dumbledore90/zmk-config/docs/左手_配置座標表.md

---
project: oyayubi_01
type: PCB配置座標表（左手）
updated: 2026-09-21 (v2)
source: oya01_Assemble_L.kicad_pcb (2a0195ec) 実測 + pin_assignment.md v1.0
---

# 左手 配置座標表（27キー）

## v2での変更

**COL0 / COL4 のスタガー量を実機に合わせて更新。** 初版は両方0mmとしていたが、
実基板では COL0 = 1.23mm / COL4 = 2.18mm 上にオフセットしている（意図的な調整）。
以下の表はすべて **PCB実測値**。

---

## 使い方

1. グリッド: **ユーザー定義 X = `18` / Y = `17/4` (=4.25)**
   ※ COL0 / COL4 は半端なオフセットなので、`E` キーで数値直接入力する
2. フットプリントを選択 → **`E` キー** → プロパティの位置 X / Y に数値入力
3. **原点(0,0) = COL2 × ROW0 (SW11 / `#`) の中心** = 最上段キー

---

## 座標表

| SW | 行 | 列 | キー | X (mm) | Y (mm) | ダイオード |
|---|---|---|---|---:|---:|---|
| **SW1** | Row0 | Col0 | ! (?) | 0 | **11.52** | D1 |
| **SW6** | Row0 | Col1 | @ (/) | 18 | 4.25 | D6 |
| **SW11** | Row0 | Col2 | # (F2) | 36 | 0 | D11 |
| **SW16** | Row0 | Col3 | $ (F3) | 54 | 8.5 | D16 |
| **SW21** | Row0 | Col4 | % (F4) | 72 | **10.57** | D21 |
| **SW2** | Row1 | Col0 | Q | 0 | **28.52** | D2 |
| **SW7** | Row1 | Col1 | W | 18 | 21.25 | D7 |
| **SW12** | Row1 | Col2 | E (7) | 36 | 17 | D12 |
| **SW17** | Row1 | Col3 | R (8) | 54 | 25.5 | D17 |
| **SW22** | Row1 | Col4 | T (9) | 72 | **27.57** | D22 |
| **SW3** | Row2 | Col0 | A | 0 | **45.52** | D3 |
| **SW8** | Row2 | Col1 | S | 18 | 38.25 | D8 |
| **SW13** | Row2 | Col2 | D (4) | 36 | 34 | D13 |
| **SW18** | Row2 | Col3 | F (5) | 54 | 42.5 | D18 |
| **SW23** | Row2 | Col4 | G (6) | 72 | **44.57** | D23 |
| **SW4** | Row3 | Col0 | Z (↑) | 0 | **62.52** | D4 |
| **SW9** | Row3 | Col1 | X (0) | 18 | 55.25 | D9 |
| **SW14** | Row3 | Col2 | C (1) | 36 | 51 | D14 |
| **SW19** | Row3 | Col3 | V (2) | 54 | 59.5 | D19 |
| **SW24** | Row3 | Col4 | B (3) | 72 | **61.57** | D24 |
| **SW5** | Row4 | Col0 | shift | 0 | 80.75 | D5 |
| **SW10** | Row4 | Col1 | ctrl (←) | 18 | 80.75 | D10 |
| **SW15** | Row4 | Col2 | option (↓) | 36 | 80.75 | D15 |
| **SW20** | Row4 | Col3 | win/cmd (→) | 54 | 80.75 | D20 |
| **SW25** | Row4 | Col4 | alt | 72 | 80.75 | D25 |
| **SW26** | Row4 | Col5 | space | 90 | 80.75 | D26 |
| **SW27** | Row4 | Col6 | 空きキー | 108 | 80.75 | **D27** |

- ダイオード番号は **D番号 = SW番号**（SW1〜SW26）。**例外は SW27 → D27** のみ
- SW28 = スライドスイッチ、SW29 = リセットスイッチ（マトリクス外）
- ダイオードは全数 **スイッチ中心から (0, −5.0) / rot=0 / F.Cu**（27個すべて実測で一致）

---

## 列X座標とスタガー

| 列 | Col0 | Col1 | Col2 | Col3 | Col4 | Col5 | Col6 |
|---|---:|---:|---:|---:|---:|---:|---:|
| X (mm) | 0 | 18 | 36 | 54 | 72 | 90 | 108 |
| 指 | 小指 | 薬指 | 中指 | 人差 | 人差(内) | 親指 | 親指(内) |
| **上オフセット (mm)** | **1.23** | 8.5 | 12.75 | 4.25 | **2.18** | 0 | 0 |
| 右手の対応列 | — | Col4 | Col3 | Col2 | — | Col6 | Col7 |

- **中指列 (Col2) が最も高い**
- Col1 / Col2 / Col3 は右手と完全な鏡像（8.5 / 12.75 / 4.25）
- **Col0 と Col4 は左手独自**。小指列と人差し指内側列をわずかに持ち上げている
- 最下段 (Row4) は**スタガーなしのフラット行** — 全列 Y=80.75
- 行番号の向き: **Row0 = 最上段 / Row4 = 最下段**

### Y値の計算式

```
Row0〜Row3 :  Y = (12.75 + 17 × Row) − 列オフセット
Row4       :  Y = 80.75 （全列共通、オフセット無視）
```

---

## トラックパッド (φ30mm)

| 項目 | 値 |
|---|---|
| 中心 | **(102.50, 54.00)** |
| マーカー円 | φ30 / User.1 レイヤー |
| **銅ベタ キープアウト** | **φ34 / 中心同じ / F.Cu + B.Cu** |
| キープアウト設定 | 配線=許可 / ビア=禁止 / パッド=禁止 / **ベタ塗り=禁止** |
| 円内を通る配線 | **ゼロ**（実測確認済み） |
| マージン | パッド外周から 2.0mm 均等 |

静電容量式センサーの直下にソリッドGNDがあると寄生容量が増えて感度が落ちるため、
両面ともベタを抜いてある。

---

## 周辺部品の実装座標

| 部品 | X | Y | 角度 | レイヤー |
|---|---:|---:|---|---|
| U1 (XIAO nRF52840 Plus) | 94.655 | 12.080 | 90 | F.Cu |
| SW29 (リセット) | 100.500 | 26.140 | 180 | F.Cu |
| SW28 (スライド) | 109.390 | 2.020 | 0 | F.Cu |
| J1 (電池コネクタ) | 110.150 | 31.100 | −90 | **B.Cu** |
| Track_pad1 (FFC変換) | 89.120 | 35.705 | 0 | F.Cu |

右手と違い COL0〜COL4 が5行フルに埋まっているため、周辺部品は**内側（高X側）**に配置。
トラックパッド円の外に出すため、FFCコネクタは円の左上に置いている。

### ネジ穴 (M2 / φ2.2)

| | H1 | H2 | H3 | H4 | H5 | H6 | H7 |
|---|---:|---:|---:|---:|---:|---:|---:|
| X | 117.00 | 23.51 | −10.51 | −10.25 | 41.13 | 117.02 | 117.40 |
| Y | 3.12 | −7.43 | 2.49 | 90.74 | 67.74 | 68.39 | 90.80 |

---

## 全体寸法

| | 左手 | 右手 |
|---|---|---|
| 基板外形 | **133.40 × 103.74 mm** | 150.84 × 103.03 mm |
| 外形範囲 | X[−13.39, 120.01] / Y[−10.21, 93.53] | — |
| キー数 | 27 | 37 + エンコーダ |
| 穴総数 | 387 | 530 |

---

## 配線ルール（右手と共通・実測で一致確認済み）

| 種類 | レイヤー | 線幅 |
|---|---|---|
| ROW (カソード連結・横) | **F.Cu** | 0.3 mm |
| COL (スイッチpad1連結・縦) | **B.Cu** | 0.3 mm |
| スイッチpad2 ⇔ ダイオードアノード | **F.Cu** | 0.3 mm |
| Bat+ / BAT_SW / Reset | F.Cu | 0.4 mm |
| GND | 両面ベタ（トラックパッド下は除外） | — |
| ビア | — | φ0.8 / drill 0.4 |

実測: 0.3mm × 251本 / 0.4mm × 27本、ビア19本（GND 15 + 層移動 7... のうちGND15）。
