dumbledore90/zmk-config/docs/右手_配置座標表.md

---
project: oyayubi_01
type: PCB配置座標表（右手）
updated: 2026-09-27
source: oya01_Assemble_R_v2.kicad_pcb のネット接続とフットプリント座標を直読み
---

# 右手 配置座標表（37キー + エンコーダ）

## 使い方

1. **原点(0,0) = ROW3 × COL0 (SW1)** ではなく、**Y基準は Col1 の Row0 = 12.75**
2. 行の向き: **Row0 = 最上段 / Row4 = 最下段**
3. 列 X は 18mm 等間隔（Col0=0 〜 Col7=126）

## 座標表

| Row | Col | SW | X (mm) | Y (mm) | ダイオード |
|---|---|---|---:|---:|---|
| Row0 | Col1 | **SW3** | 18 | 12.75 | D3 |
| Row0 | Col2 | **SW8** | 36 | 8.5 | D8 |
| Row0 | Col3 | **SW13** | 54 | 0 | D13 |
| Row0 | Col4 | **SW18** | 72 | 4.25 | D18 |
| Row0 | Col5 | **SW23** | 90 | 12.75 | D23 |
| Row0 | Col6 | **SW28** | 108 | 12.75 | D28 |
| Row0 | Col7 | **SW33** | 126 | 12.75 | D33 |
| Row1 | Col1 | **SW4** | 18 | 29.75 | D4 |
| Row1 | Col2 | **SW9** | 36 | 25.5 | D9 |
| Row1 | Col3 | **SW14** | 54 | 17 | D14 |
| Row1 | Col4 | **SW19** | 72 | 21.25 | D19 |
| Row1 | Col5 | **SW24** | 90 | 29.75 | D24 |
| Row1 | Col6 | **SW29** | 108 | 29.75 | D29 |
| Row1 | Col7 | **SW34** | 126 | 29.75 | D34 |
| Row2 | Col0 | **SW39** | -1 | 46 | D38 ← **エンコーダのプッシュ** |
| Row2 | Col1 | **SW5** | 18 | 46.75 | D5 |
| Row2 | Col2 | **SW10** | 36 | 42.5 | D10 |
| Row2 | Col3 | **SW15** | 54 | 34 | D15 |
| Row2 | Col4 | **SW20** | 72 | 38.25 | D20 |
| Row2 | Col5 | **SW25** | 90 | 46.75 | D25 |
| Row2 | Col6 | **SW30** | 108 | 46.75 | D30 |
| Row2 | Col7 | **SW35** | 126 | 46.75 | D35 |
| Row3 | Col0 | **SW1** | 0 | 63.75 | D1 |
| Row3 | Col1 | **SW6** | 18 | 63.75 | D6 |
| Row3 | Col2 | **SW11** | 36 | 59.5 | D11 |
| Row3 | Col3 | **SW16** | 54 | 51 | D16 |
| Row3 | Col4 | **SW21** | 72 | 55.25 | D21 |
| Row3 | Col5 | **SW26** | 90 | 63.75 | D26 |
| Row3 | Col6 | **SW31** | 108 | 63.75 | D31 |
| Row3 | Col7 | **SW36** | 126 | 63.75 | D36 |
| Row4 | Col0 | **SW2** | 0 | 80.75 | D2 |
| Row4 | Col1 | **SW7** | 18 | 80.75 | D7 |
| Row4 | Col2 | **SW12** | 36 | 80.75 | D12 |
| Row4 | Col3 | **SW17** | 54 | 80.75 | D17 |
| Row4 | Col4 | **SW22** | 72 | 80.75 | D22 |
| Row4 | Col5 | **SW27** | 90 | 80.75 | D27 |
| Row4 | Col6 | **SW32** | 108 | 80.75 | D32 |
| Row4 | Col7 | **SW37** | 126 | 80.75 | D37 |

- **Row2 × Col0 = SW39（ロータリーエンコーダのプッシュスイッチ）**。通常のキースイッチではない
- SW39 の座標 (−1.00, 46.00) はエンコーダ本体の中心。キー格子から外れている
- **Col0 は Row2 / Row3 / Row4 の3セルのみ**。Row0・Row1 に Col0 は存在しない
- ダイオード番号は D番号 = SW番号。**例外は SW39 → D38**
- ダイオードは全数 **裏面 (B.Cu) / rot=0 / カソード(pad1) はスイッチ中心から X−1.65**

## 列Xとスタガー

| 列 | Col0 | Col1 | Col2 | Col3 | Col4 | Col5 | Col6 | Col7 |
|---|---:|---:|---:|---:|---:|---:|---:|---:|
| X (mm) | 0 | 18 | 36 | 54 | 72 | 90 | 108 | 126 |
| **上オフセット (mm)** | **0** | **0** | **4.25** | **12.75** | **8.50** | **0** | **0** | **0** |
| 左手で同じ値を持つ列 | — | — | Col3 (人差) | Col2 (中指) | Col1 (薬指) | — | — | — |
| 指（**スタガー値からの推定**） | 親指(内) | 人差(内) | 人差 | 中指 | 薬指 | 小指 | 小指(外) | 小指(外2) |

> ⚠️ **指の行は推定。** 基板ファイルに指の情報は入っていないので、
> 「左手と同じスタガー値を持つ列は同じ指」という仮定から逆算した。
> 実際の運指と違っていたら教えてほしい。座標そのものは実測値で確実。

### Y値の計算式

```
Row0〜Row3 :  Y = (12.75 + 17 × Row) − 列オフセット
Row4       :  Y = 80.75 （全列共通、オフセット無視）
```

左手とまったく同じ式が使える。

## 左右のスタガー比較

指ごとに並べ直すと、**4本指のスタガーは左右で完全に一致している**。

| 指 | 左手 | 右手 | 一致 |
|---|---|---|---|
| 人差 | Col3 = **4.25** | Col2 = **4.25** | ✅ |
| 中指 | Col2 = **12.75** | Col3 = **12.75** | ✅ |
| 薬指 | Col1 = **8.50** | Col4 = **8.50** | ✅ |
| 小指 | Col0 = 1.23 | Col5 = 0 | 差 1.23mm |

**左右で違うのは2点だけ：**

1. **小指列が左は 1.23mm 上、右は 0**（わずかな差）
2. **列数が違う。** 左は7列、右は8列
   - 左には「人差し指の内側」列 (Col4, offset 2.18) がある
   - 右には**小指側に追加の2列** (Col6, Col7) がある。どちらもオフセット 0

つまり**基本のスタガー設計は左右対称で、周辺列の数だけが非対称**。
右手が37キー・左手が27キーという構成はここから来ている。

## ZMK 統合レイアウトの位置順（検証済み）

左7列 + 右8列 = **columns 15** / 右の **col-offset = 7**。
行ごとに「左を左から右へ → 右を左から右へ」の順に並べると次のようになる。

| 行 | 左（Col） | 右（Col） | その行のキー数 |
|---|---|---|---:|
| Row0 | 0,1,2,3,4 | 1,2,3,4,5,6,7 | 12 |
| Row1 | 0,1,2,3,4 | 1,2,3,4,5,6,7 | 12 |
| Row2 | 0,1,2,3,4 | **0**,1,2,3,4,5,6,7 | 13 |
| Row3 | 0,1,2,3,4 | **0**,1,2,3,4,5,6,7 | 13 |
| Row4 | 0,1,2,3,4,5,6 | 0,1,2,3,4,5,6,7 | 15 |
| | | **合計** | **65** |

統合座標での列番号は、左が 0〜6、右が **7 + 右Col** （右Col0 → 7、右Col7 → 14）。

## 検証記録（2026-09-27）

- 基板ファイルのネット接続から Row/Col を直接抽出。**38セル・重複ゼロ**
- 行別セル数 Row0:7 / Row1:7 / Row2:8 / Row3:8 / Row4:8
- 回路図のシンボル定義（pin15=D11, pin21=D17, pin22=D18, pin23=D19）とも一致
- 左手も同時に再検証。**27セル・重複ゼロ**、既存の左手座標表と完全一致
