dumbledore90/zmk-config/docs/oya01_Assemble_R_v2.kicad_pcb

## KiCad design docs/oya01_Assemble_R_v2.kicad_pcb (2026-09-27)

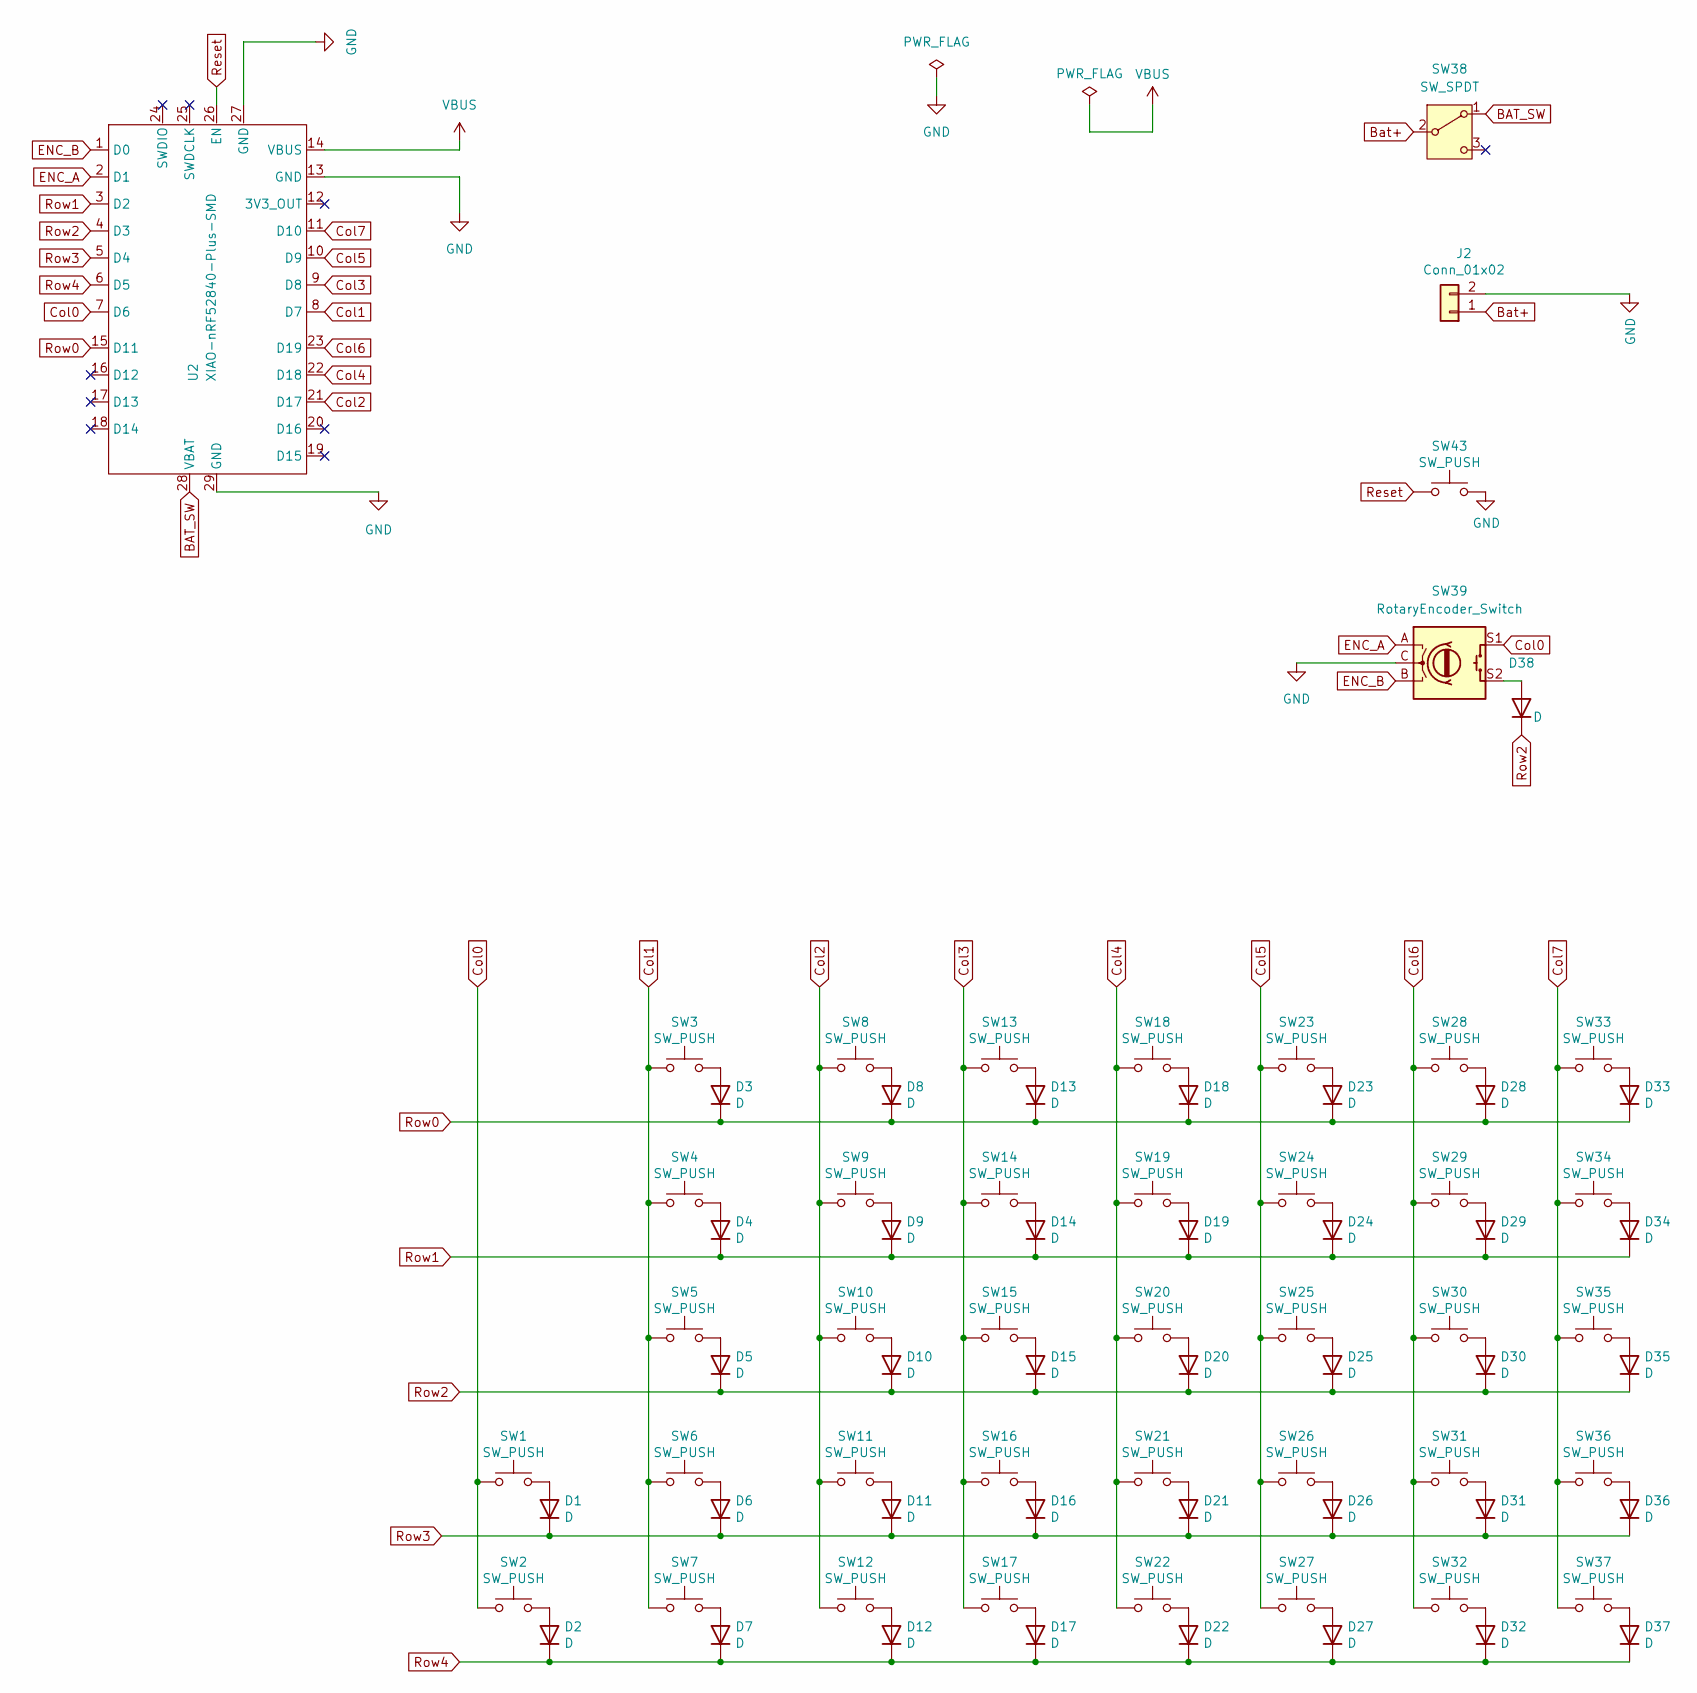
[picture p1: schematic oya01_Assemble_R_v2.kicad_sch]

Parts:
D1, D2, D3, D4, D5, D6, D7, D8, D9, D10, D11, D12, D13, D14, D15, D16, D17, D18, D19, D20, D21, D22, D23, D24, D25, D26, D27, D28, D29, D30, D31, D32, D33, D34, D35, D36, D37, D38: D; D_SOD-123
J2: Conn_01x02; JST_PH_S2B-PH-K_1x02_P2.00mm_Horizontal
SW1, SW2, SW3, SW4, SW5, SW6, SW7, SW8, SW9, SW10, SW11, SW12, SW13, SW14, SW15, SW16, SW17, SW18, SW19, SW20, SW21, SW22, SW23, SW24, SW25, SW26, SW27, SW28, SW29, SW30, SW31, SW32, SW33, SW34, SW35, SW36, SW37: SW_PUSH; Kailh_Choc_V1_Hotswap_thin_via
SW38: SW_SPDT; TGSW_MSK-12D19
SW39: RotaryEncoder_Switch; RotaryEncoder_EC12E
SW43: SW_PUSH; ResetSW
U2: XIAO-nRF52840-Plus-SMD

Connections:
BAT_SW: SW38.1 (A), U2.28 (VBAT)
Bat+: J2.1, SW38.2 (B)
Col0: SW1.1, SW2.1, SW39.S1, U2.7 (D6)
Col1: SW3.1, SW4.1, SW5.1, SW6.1, SW7.1, U2.8 (D7)
Col2: SW8.1, SW9.1, SW10.1, SW11.1, SW12.1, U2.21 (D17)
Col3: SW13.1, SW14.1, SW15.1, SW16.1, SW17.1, U2.9 (D8)
Col4: SW18.1, SW19.1, SW20.1, SW21.1, SW22.1, U2.22 (D18)
Col5: SW23.1, SW24.1, SW25.1, SW26.1, SW27.1, U2.10 (D9)
Col6: SW28.1, SW29.1, SW30.1, SW31.1, SW32.1, U2.23 (D19)
Col7: SW33.1, SW34.1, SW35.1, SW36.1, SW37.1, U2.11 (D10)
ENC_A: SW39.A, U2.2 (D1)
ENC_B: SW39.B, U2.1 (D0)
GND: J2.2, SW39.C, SW43.2, U2.13 (GND), U2.27 (GND), U2.29 (GND)
unnamed: D1.2 (A), SW1.2
unnamed: D2.2 (A), SW2.2
unnamed: D3.2 (A), SW3.2
unnamed: D4.2 (A), SW4.2
unnamed: D5.2 (A), SW5.2
unnamed: D6.2 (A), SW6.2
unnamed: D7.2 (A), SW7.2
unnamed: D8.2 (A), SW8.2
unnamed: D9.2 (A), SW9.2
unnamed: D10.2 (A), SW10.2
unnamed: D11.2 (A), SW11.2
unnamed: D12.2 (A), SW12.2
unnamed: D13.2 (A), SW13.2
unnamed: D14.2 (A), SW14.2
unnamed: D15.2 (A), SW15.2
unnamed: D16.2 (A), SW16.2
unnamed: D17.2 (A), SW17.2
unnamed: D18.2 (A), SW18.2
unnamed: D19.2 (A), SW19.2
unnamed: D20.2 (A), SW20.2
unnamed: D21.2 (A), SW21.2
unnamed: D22.2 (A), SW22.2
unnamed: D23.2 (A), SW23.2
unnamed: D24.2 (A), SW24.2
unnamed: D25.2 (A), SW25.2
unnamed: D26.2 (A), SW26.2
unnamed: D27.2 (A), SW27.2
unnamed: D28.2 (A), SW28.2
unnamed: D29.2 (A), SW29.2
unnamed: D30.2 (A), SW30.2
unnamed: D31.2 (A), SW31.2
unnamed: D32.2 (A), SW32.2
unnamed: D33.2 (A), SW33.2
unnamed: D34.2 (A), SW34.2
unnamed: D35.2 (A), SW35.2
unnamed: D36.2 (A), SW36.2
unnamed: D37.2 (A), SW37.2
unnamed: D38.2 (A), SW39.S2
Reset: SW43.1, U2.26 (EN)
Row0: D3.1 (K), D8.1 (K), D13.1 (K), D18.1 (K), D23.1 (K), D28.1 (K), D33.1 (K), U2.15 (D11)
Row1: D4.1 (K), D9.1 (K), D14.1 (K), D19.1 (K), D24.1 (K), D29.1 (K), D34.1 (K), U2.3 (D2)
Row2: D5.1 (K), D10.1 (K), D15.1 (K), D20.1 (K), D25.1 (K), D30.1 (K), D35.1 (K), D38.1 (K), U2.4 (D3)
Row3: D1.1 (K), D6.1 (K), D11.1 (K), D16.1 (K), D21.1 (K), D26.1 (K), D31.1 (K), D36.1 (K), U2.5 (D4)
Row4: D2.1 (K), D7.1 (K), D12.1 (K), D17.1 (K), D22.1 (K), D27.1 (K), D32.1 (K), D37.1 (K), U2.6 (D5)
VBUS: U2.14 (VBUS)

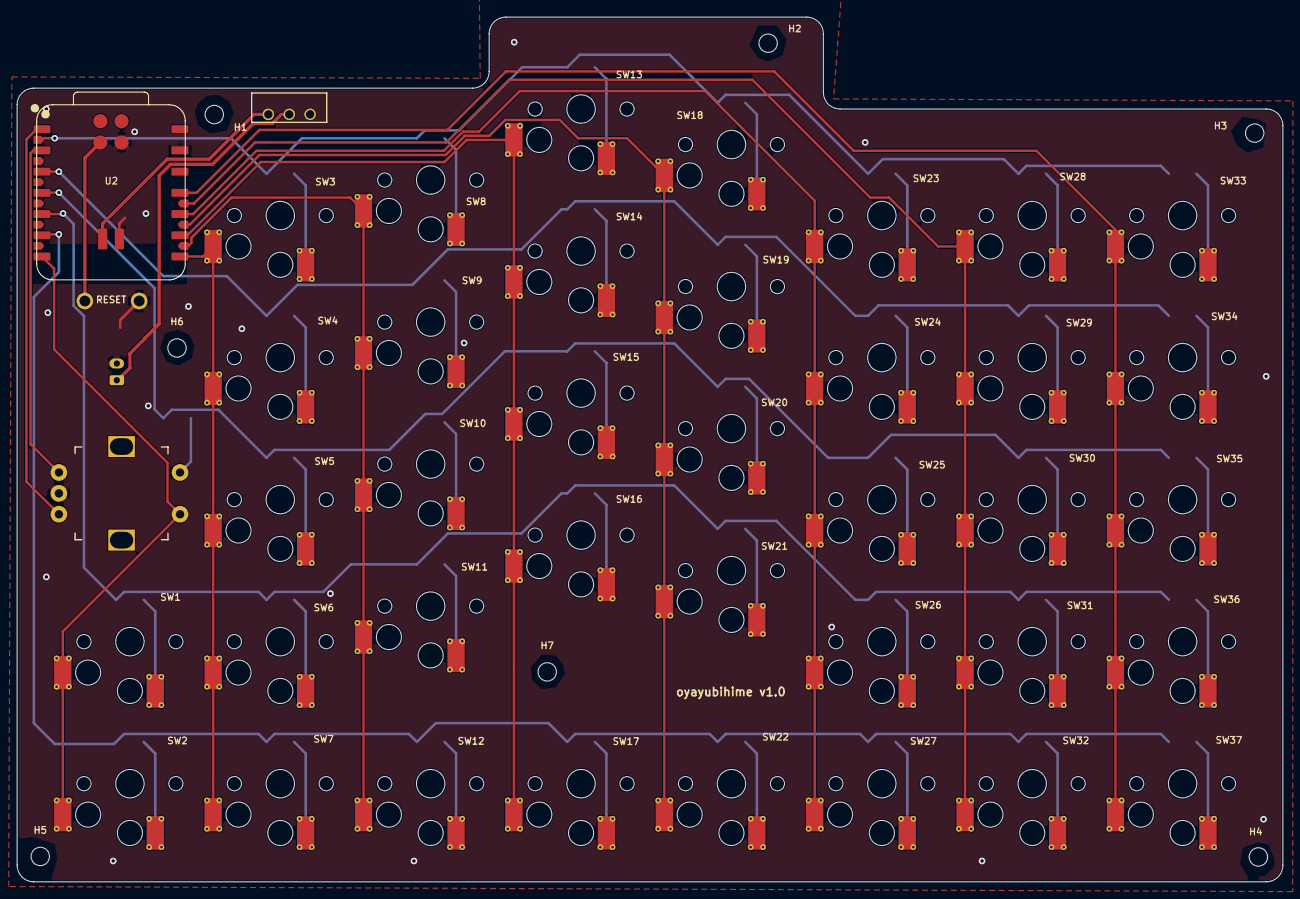
[picture p2: board oya01_Assemble_R_v2.kicad_pcb from above]

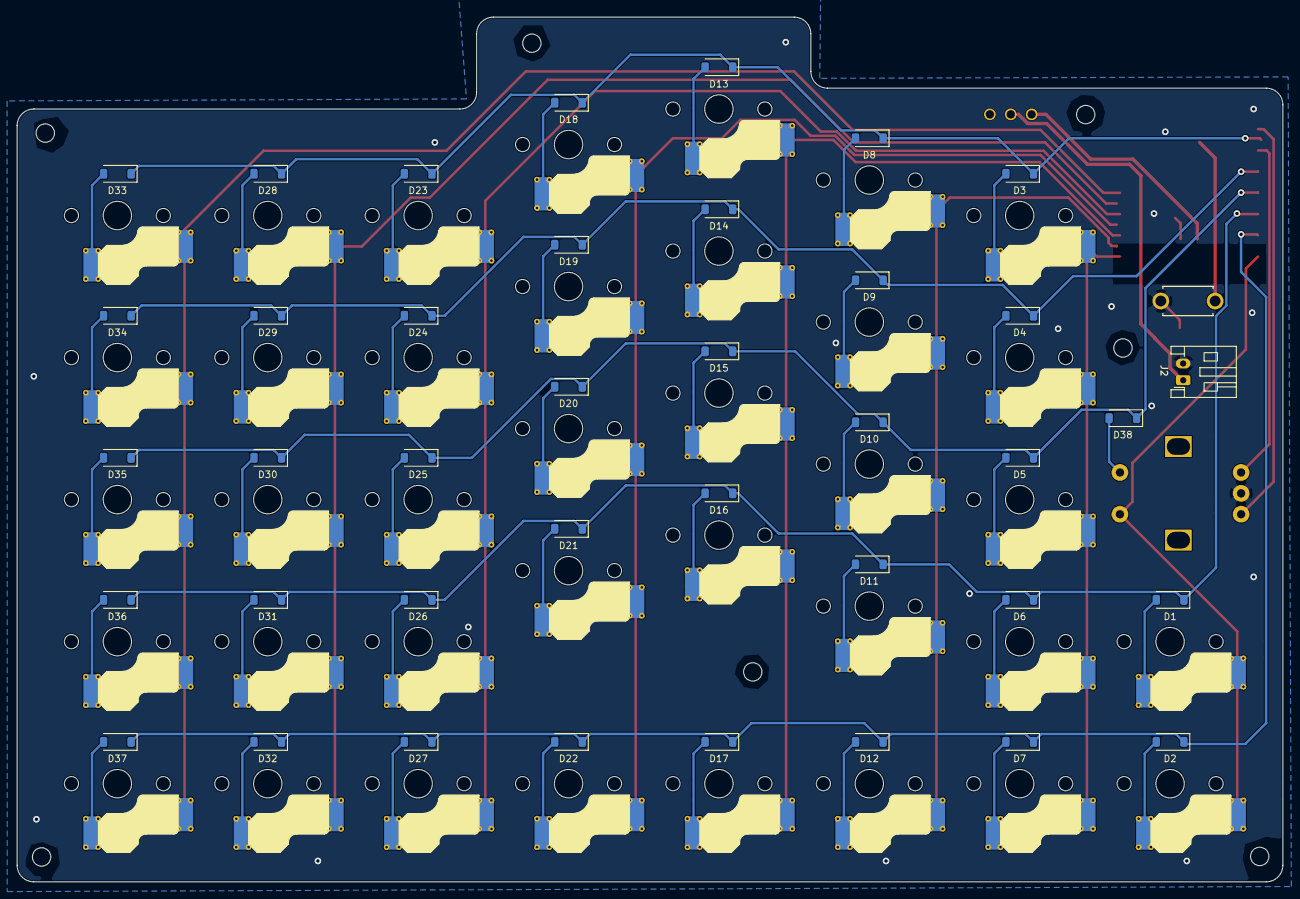
[picture p3: board oya01_Assemble_R_v2.kicad_pcb from below]

Board: 2 copper layers, 151.5 x 103.5 mm, 87 parts (39 on the bottom side), 57 nets.

Other parts of the board:
H1, H2, H3, H4, H5, H6, H7: MountingHole_2.2mm_M2
