dumbledore90/zmk-config/(commit log)

2026-09-27 資料とCLAUDE.mdを追加、oyayubi_01シールドの雛形を生成
    [oya01_Assemble_L_v2.kicad_pcb, oya01_Assemble_L_v2.kicad_sch, oya01_Assemble_R_v2.kicad_pcb, oya01_Assemble_R_v2.kicad_sch]
2026-09-27 oyayubi_01 シールドを実機マトリクスに合わせて完成
    - default_transform: columns=15/rows=5、65キー map を実機マトリクス通りに記述
    （Row0/1 は右 Col0 なし、Row2-4 は右 Col0 あり・エンコーダプッシュ）
    - overlay 2 ファイルに row-gpios/col-gpios を移動し、全ピンを &gpio0/&gpio1 で直接指定
    （xiao_d は D11 以降未定義のため不使用）
    - D17/D19 使用箇所に TODO:要実機検証 コメントを付与
    - 右 overlay に EC11 エンコーダノードと zmk,keymap-sensors を追加
    - oyayubi_01-layouts.dtsi: 65 キー全座標を記述
    （スケール 1mm=100 cku でスタガー値が整数、丸め誤差ゼロ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
2026-09-27 Kconfig: EC11_TRIGGER_GLOBAL_THREAD の default y を削除
    choice シンボルには default y が使えず Kconfig warnings → ビルドエラーになるため。
    ZMK の EC11 Kconfig がすでに default EC11_TRIGGER_GLOBAL_THREAD を持つので不要。
